gregorsun/CANPiController/KiCAD/PIC18F57Q84_ATA6560.kicad_pcb

## KiCad design KiCAD/PIC18F57Q84_ATA6560.kicad_pcb (2021-04-29)

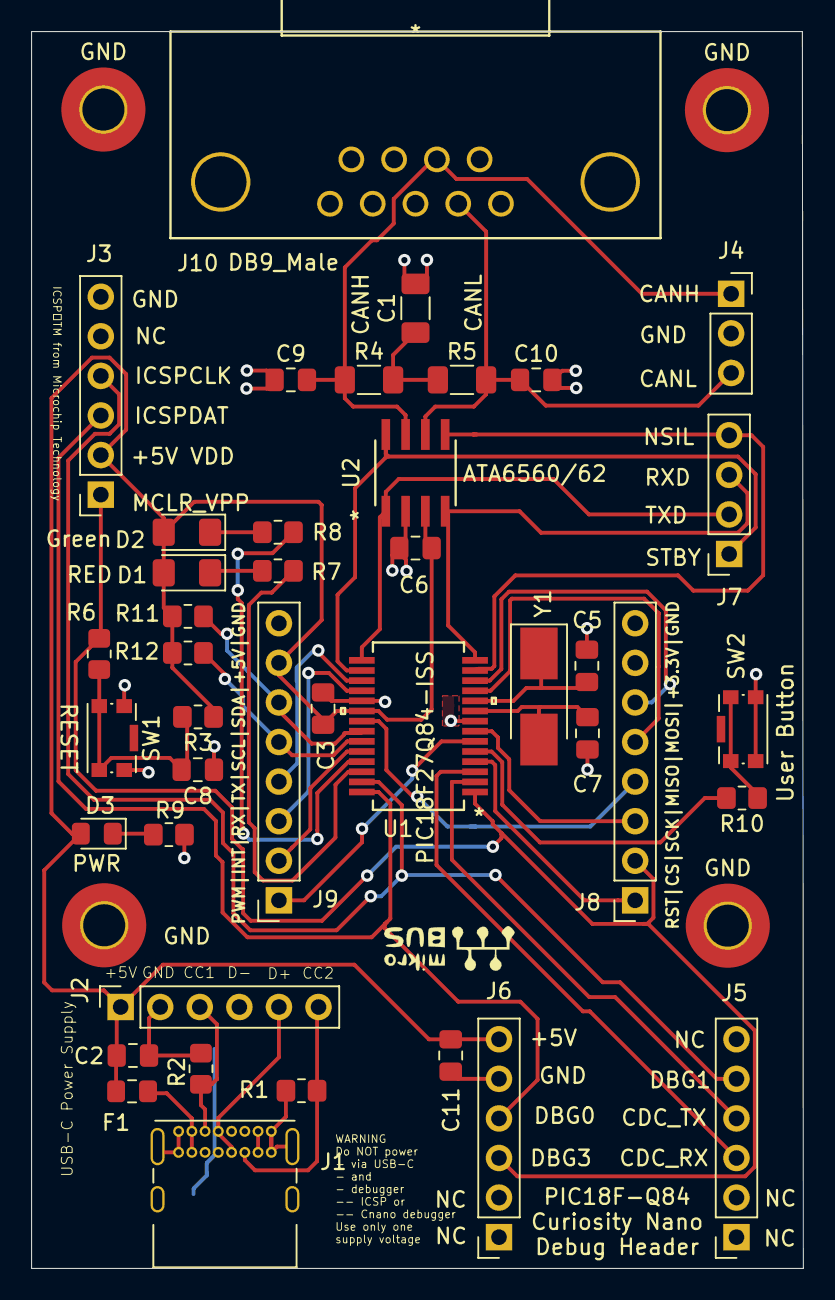
[picture p9: board PIC18F57Q84_ATA6560.kicad_pcb from above]

Board: 2 copper layers, 49.5 x 79.4 mm, 45 parts (0 on the bottom side), 40 nets.

Parts:
C1: 4.7n/50V; C_1206_3216Metric_Pad1.33x1.80mm_HandSolder
C2, C11: 2.2u; C_0805_2012Metric_Pad1.18x1.45mm_HandSolder
C3, C6: 100n; C_0805_2012Metric_Pad1.18x1.45mm_HandSolder
C5, C7: 26p; C_0805_2012Metric_Pad1.18x1.45mm_HandSolder
C8: 0.1u; C_0805_2012Metric_Pad1.18x1.45mm_HandSolder
C9, C10: 100p/50V; C_0805_2012Metric_Pad1.18x1.45mm_HandSolder
D1: RED; LED_1206_3216Metric_Pad1.42x1.75mm_HandSolder
D2: Green; LED_1206_3216Metric_Pad1.42x1.75mm_HandSolder
D3: Yellow; LED_0805_2012Metric_Pad1.15x1.40mm_HandSolder
F1: Fuse MC36213; Fuse_0805_2012Metric_Pad1.15x1.40mm_HandSolder
GND: MountingHole_2.7mm_M2.5_Pad_TopBottom
GND#2, GND#3, GND#4: MountingHole_2.7mm_M2.5_Pad_TopBottom
J1: USB_C_Receptacle_USB2.0; USB_C_Receptacle_GCT_USB4085
J2, J3, J5, J6: Conn_01x06; PinSocket_1x06_P2.54mm_Vertical
J4: Conn_01x03; PinSocket_1x03_P2.54mm_Vertical
J7: Conn_01x04; PinSocket_1x04_P2.54mm_Vertical
J8, J9: Conn_01x08; PinSocket_1x08_P2.54mm_Vertical
J10: DB9_Male; 5747840-4
R1, R2: 5.1k; R_0805_2012Metric_Pad1.20x1.40mm_HandSolder
R3, R11, R12: 10k; R_0805_2012Metric_Pad1.20x1.40mm_HandSolder
R4, R5: 60R/0.5W; R_1206_3216Metric_Pad1.30x1.75mm_HandSolder
R6: 470R; R_0805_2012Metric_Pad1.20x1.40mm_HandSolder
R7, R8, R9, R10: 1k; R_0805_2012Metric_Pad1.20x1.40mm_HandSolder
SW1, SW2: SW_Push; SW_Push_1P1T-SH_NO_CK_KMR2xxG
U1: PIC18F27Q84-ISS; PIC18F27Q43-I&slash_SS
U2: ATA6560/62; ATA6561-GAQW-N
Y1: Crystal 10MHz, ABM3-10.0000MHZ-D2Y-T; Crystal_SMD_Abracon_ABM3-2Pin_5.0x3.2mm_HandSoldering

Connections:
CDC_RX: J5.3, U1.3
CDC_TX: J5.4, U1.2
DBG0: J3.3, J6.4, U1.28
DBG1: J3.4, J5.5, U1.27
DBG3: J3.1, J6.3, J8.2, R6.1, U1.1
GND: C1.2, C2.2, C3.2, C5.1, C6.1, C7.2, C8.2, C9.1, C10.2, C11.2, GND.1, GND#2.1, GND#3.1, GND#4.1, J1.A1, J1.A12, J1.B1, J1.B12, J1.S1, J2.2, J3.6, J4.2, J6.5, J8.8, J9.8, J10.3, R1.2, R2.2, R9.2, SW1.1, SW2.2, U1.8, U1.19, U2.2
NSIL: J7.4, U1.13, U2.5
unnamed: C1.1, R4.2, R5.1
unnamed: C8.1, R3.2, R6.2, SW1.2
unnamed: C9.2, J4.1, J10.7, R4.1, U2.7
unnamed: C10.1, J4.3, J10.2, R5.2, U2.6
unnamed: D1.1, R7.1
unnamed: D2.1, R8.1
unnamed: D3.1, R9.1
unnamed: F1.2, J1.A4, J1.A9, J1.B4, J1.B9
unnamed: J1.A5, J2.3, R2.1
unnamed: J1.A6, J1.B6, J2.5
unnamed: J1.A7, J1.B7, J2.4
unnamed: J1.B5, J2.6, R1.1
unnamed: R10.1, SW2.1
OSC1: C5.2, U1.10, Y1.1
OSC2: C7.1, U1.9, Y1.2
RA2_A0: J8.1, U1.4
RA3_SW2: R10.2, U1.5
RA4_PWM: J9.1, U1.6
RA5_CS: J8.3, U1.7
RB0_SCK: J8.4, U1.21
RB1_SDA: J9.6, R11.2, U1.22
RB2_SCL: J9.5, R12.2, U1.23
RB3_INT: J9.2, U1.24
RB4_LED_GREEN: R8.2, U1.25
RB5_LED_RED: R7.2, U1.26
RC0_MISO: J8.5, U1.11
RC1_MOSI: J8.6, U1.12
RC6_TX: J9.4, U1.17
RC7_RX: J9.3, U1.18
RXD: J7.3, U1.14, U2.4
STBY: J7.1, U1.16, U2.8
TXD: J7.2, U1.15, U2.1
VTG: C2.1, C3.1, C6.2, C11.1, D1.2, D2.2, D3.2, F1.1, J2.1, J3.2, J6.6, J9.7, R3.1, R11.1, R12.1, U1.20, U2.3
