gregorsun/CANPiController/PIC18F27Q84_CAN_node.X/interrupt_hanlder_function.h

/* 
 * File:   interrupt_hanlder_function.h
 * Author: M43998
 *
 * Created on July 1, 2021, 11:57 AM
 */

#ifndef INTERRUPT_HANLDER_FUNCTION_H
#define	INTERRUPT_HANLDER_FUNCTION_H

#ifdef	__cplusplus
extern "C" {
#endif




#ifdef	__cplusplus
}
#endif

#endif	/* INTERRUPT_HANLDER_FUNCTION_H */
